IFRN-PAAS-TI/ToqueIFRNPAAS/README.md

# ToqueIFRNPAAS

Documentação e Código Fonte do Sistema de Toque do IFRN - Campus Parelhas

## Código fonte do cliente

Encontrado na pasta [Cliente](https://github.com/marcocspc/ToqueIFRNPAAS/tree/master/Cliente). :)

## Documentação do cliente

Pode ser lida [aqui](https://github.com/marcocspc/ToqueIFRNPAAS/blob/master/Cliente/Documenta%C3%A7%C3%A3o/Manual%20do%20Sistema%20de%20Toque%20do%20IFRN%20Parelhas.pdf).
