IFRN-PAAS-TI/ToqueIFRNPAAS/Cliente/Documentação/Documento de Requisitos.odt

Requisitos Funcionais

1. O software deverá ser capaz de acionar um relé que chaveará 220V para a sineta de toque;
2. Ao ser iniciado, o sistema deverá obter a hora atual de algum servidor da rede;
3. Os toques são avisos sonoros a serem executados em determinados horários. Cada toque possui quatro atributos: “nome”, “tempo de som”, “tempo de pausa” e “repetição”. O “nome” refere-se a um dado para identificar o toque. O “tempo de som” refere-se a quanto tempo o toque deverá ser soado, o “tempo de pausa” refere-se a um silêncio que será executado logo após isso. A “repetição” indica quantas vezes este ciclo será executado;
4. O sistema deverá armazenar um conjunto de horários onde vários tipos de toque deverão ser enfileirados, cada horário (composto por hora e minuto) só poderá conter um tipo de toque.
5. Ao ser iniciado o sistema deverá obter o conjunto de horários de um servidor de rede;
6. Caso não possa obter os horários do servidor de rede, o sistema deverá executar o seguinte conjunto de horários por padrão: 07:00h, 07:45h, 08:30h, 08:50h, 09:35h, 10:20h, 10:30h, 11:15h, 12:00h, 13:00h, 13:45h, 14:30h, 14:50h; 15:35h; 16:20h, 16:30h, 17:15h; 18:00h.

Requisitos Não-Funcionais

1. O sistema deverá ser executado utilizando um Arduino Uno, Um Shield Ethernet HanRun HR911105A e um Shield de Relógio DS3231. Para acionar o alarme, deverá ser utilizado um Relé 5V que chaveará uma tensão de 220V a ser enviada para a sineta de toque;
2. O formato do conjunto de horários a ser recebido será JSON;
3. Para receber os horários, o sistema deverá consultar o servidor utilizando arquitetura Rest;
4. O método a ser utilizado deverá ser um GET na URL https://servidor:porta/horariopadrao;
5. O protocolo de obtenção da hora atual será NTP.
