IFRN-PAAS-TI/ToqueIFRNPAAS/Cliente/Documentação/Atividade.png

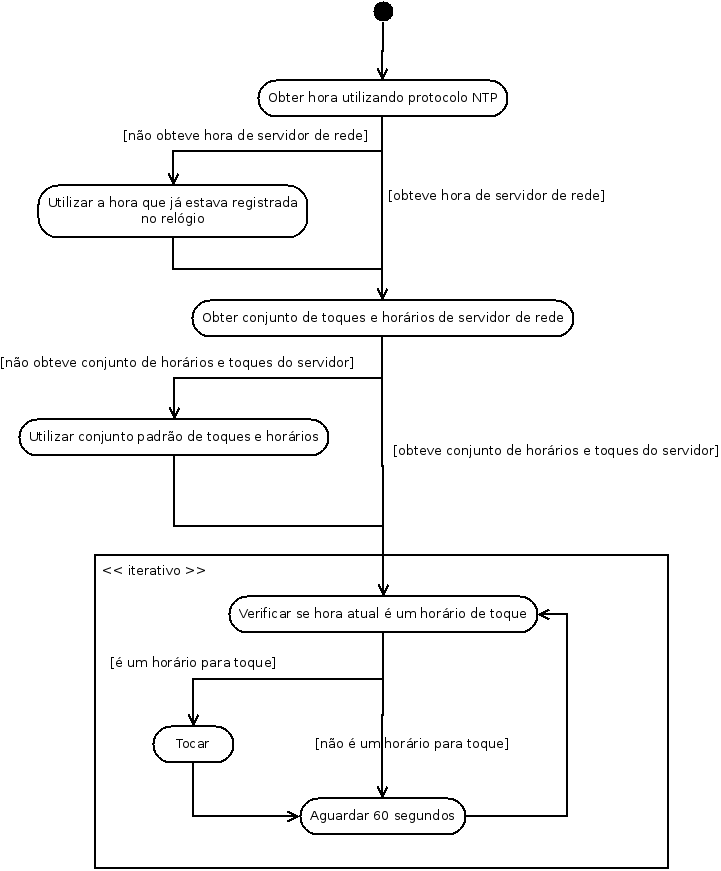
Cliente/Documentação/Atividade.png
