IFRN-PAAS-TI/ToqueIFRNPAAS/(commit log)

2018-05-17 =Funcionando para conjunto de toques padrao
2018-05-18 =Consertando diagrama de atividade
2018-06-05 Sctruct tempo agora obedece as regras de negocio
2021-11-03 alterando o codigo para funcionar sem sleep
2021-11-03 algumas alteracoes para o relay funcionar em high e a porta digital
2022-04-29 removendo codigo de reset e adicionando algumas verbosidades
    [main.h.ino]
